vad32m/acid_vaporizer/MCAD/isometry view bottom.png

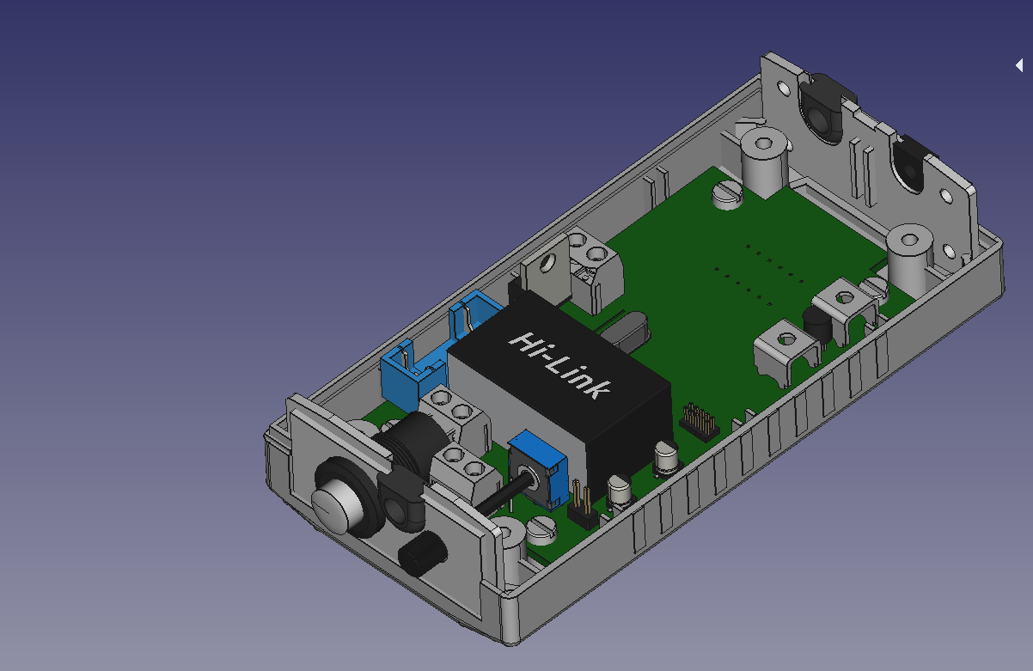
MCAD/isometry view bottom.png
