vad32m/acid_vaporizer/MCAD/isometry view top.png

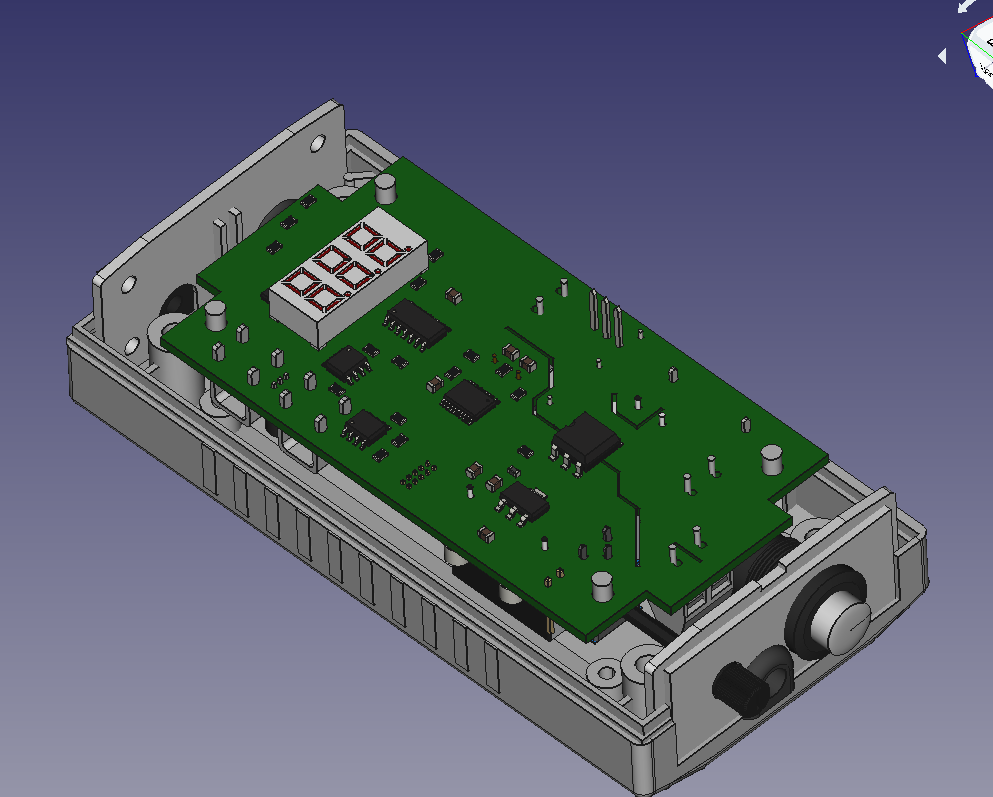
MCAD/isometry view top.png
