vad32m/acid_vaporizer/ECAD/pcb_renders.png

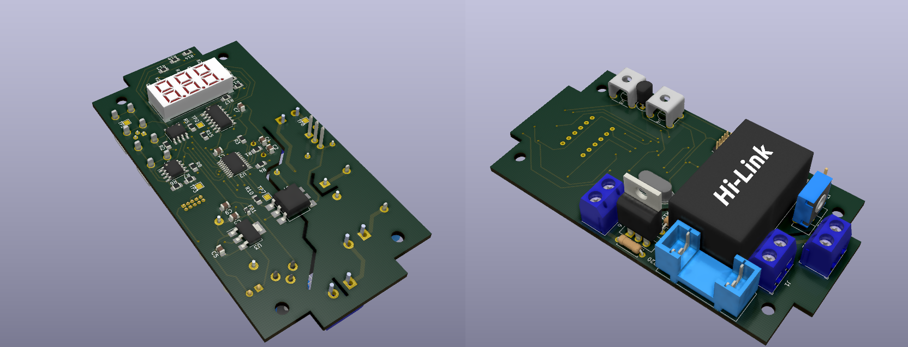
ECAD/pcb_renders.png
