vad32m/acid_vaporizer/MCAD/VAPORIZER_ASSEMBLED.FCStd

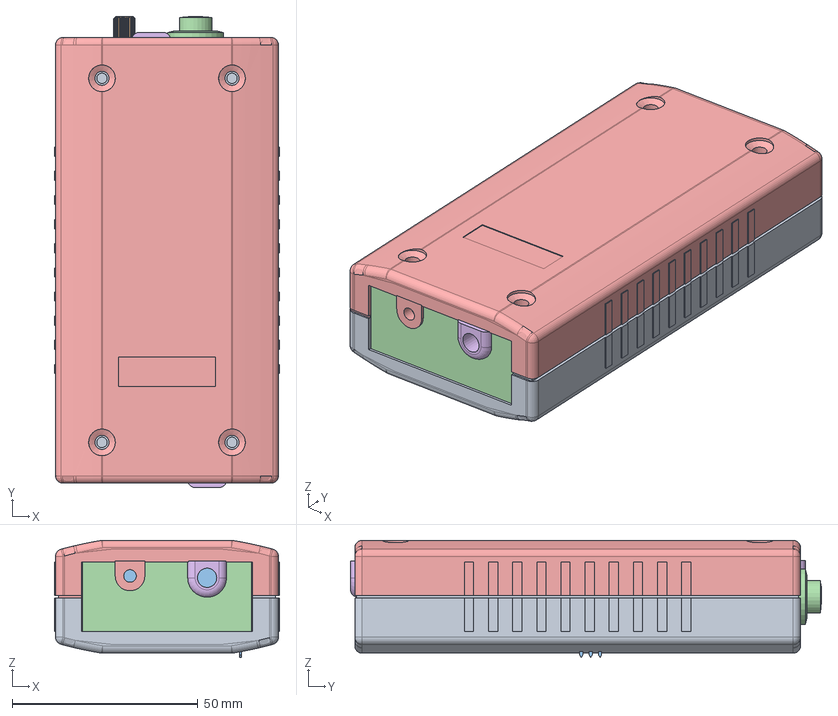
[picture p4: CAD file, 2020-11-08]
MCAD/VAPORIZER_ASSEMBLED.FCStd
60.6 x 126.8 x 31.6 mm
ENCLOSURE_TOP_001
CA9MA39_001
ENCLOSURE_SIDE_A_001
BUTTON_ASSEMBLED_001
ENCLOSURE_BOTTOM_001
FIX-GR-39_001
M3x5-Screw_001
M3x5-Screw_002
M3x5-Screw_003
M3x5-Screw_004
acid_vaporizer1_001
ENCLOSURE_SIDE_B_001
FIX-GR-35_001
FIX-GR-39_002
