vad32m/acid_vaporizer/MCAD/BUTTON_ASSEMBLED.FCStd

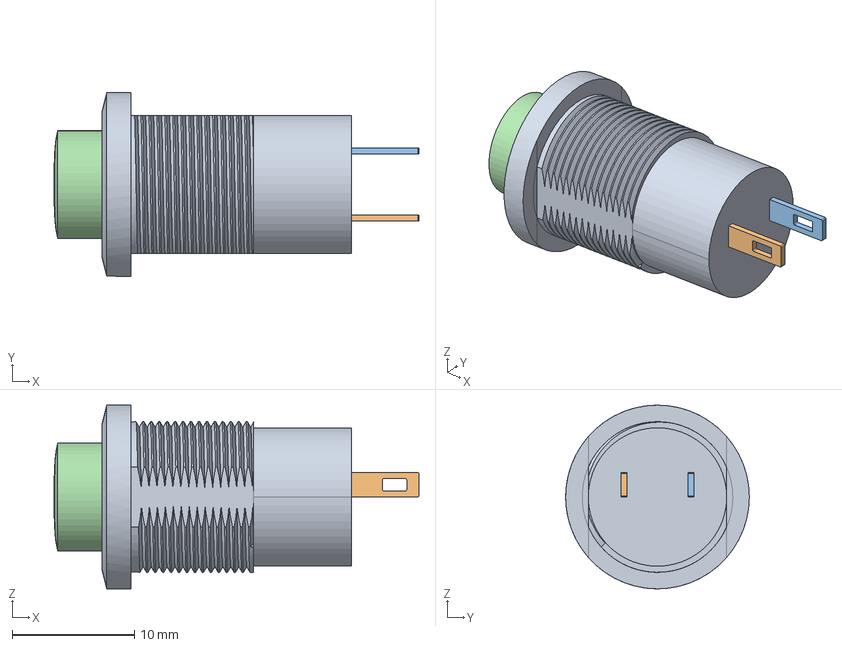
[picture p5: CAD file, 2020-11-08]
MCAD/BUTTON_ASSEMBLED.FCStd
29.8 x 15.0 x 15.0 mm
BUTTON_BODY_001
BUTTON_PIN_001
BUTTON_PIN_002
BUTTON_PAD_001
