vad32m/acid_vaporizer/MCAD/HV1216.FCStd

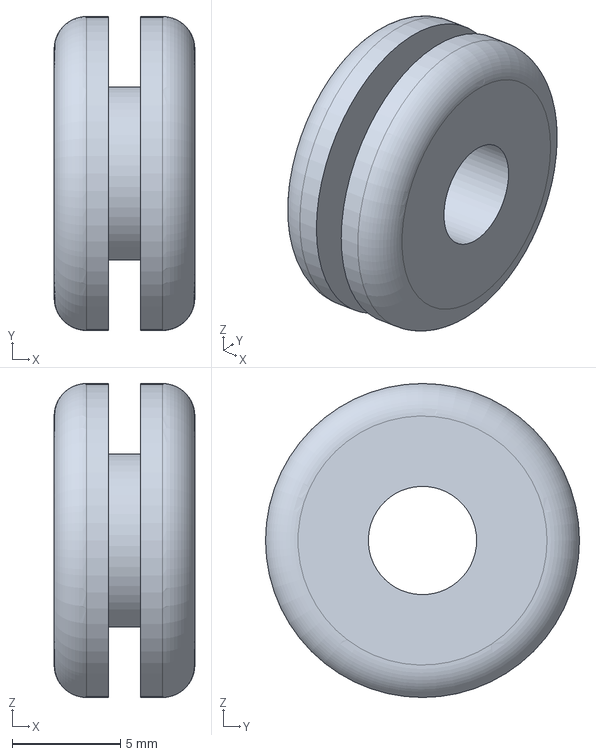
[picture p6: CAD file, 2020-11-08]
MCAD/HV1216.FCStd
6.50 x 14.5 x 14.5 mm
