vad32m/acid_vaporizer/MCAD/CA9MA39.FCStd

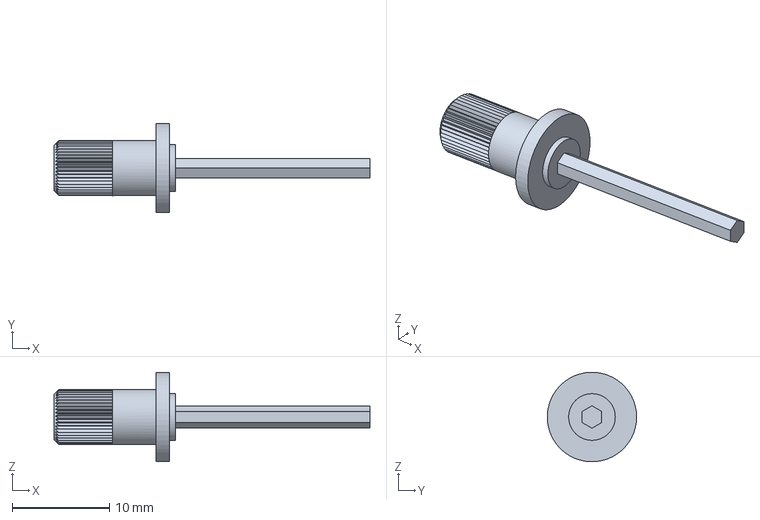
[picture p7: CAD file, 2020-11-08]
MCAD/CA9MA39.FCStd
32.5 x 9.19 x 9.20 mm
