vad32m/acid_vaporizer/MCAD/BUTTON_PIN.FCStd

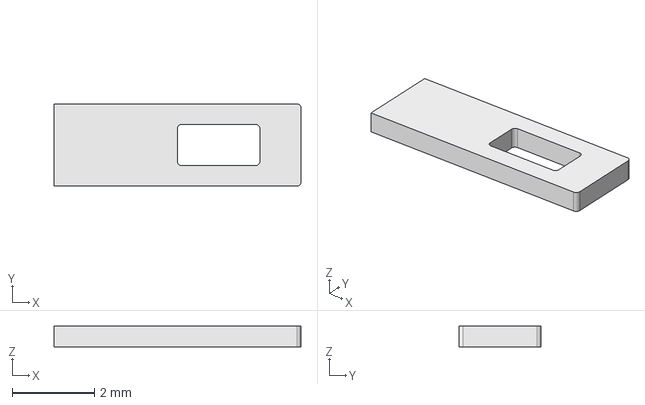
[picture p8: CAD file, 2020-11-08]
MCAD/BUTTON_PIN.FCStd
6.00 x 2.00 x 0.5 mm
