vad32m/acid_vaporizer/MCAD/FIX-GR-35.FCStd

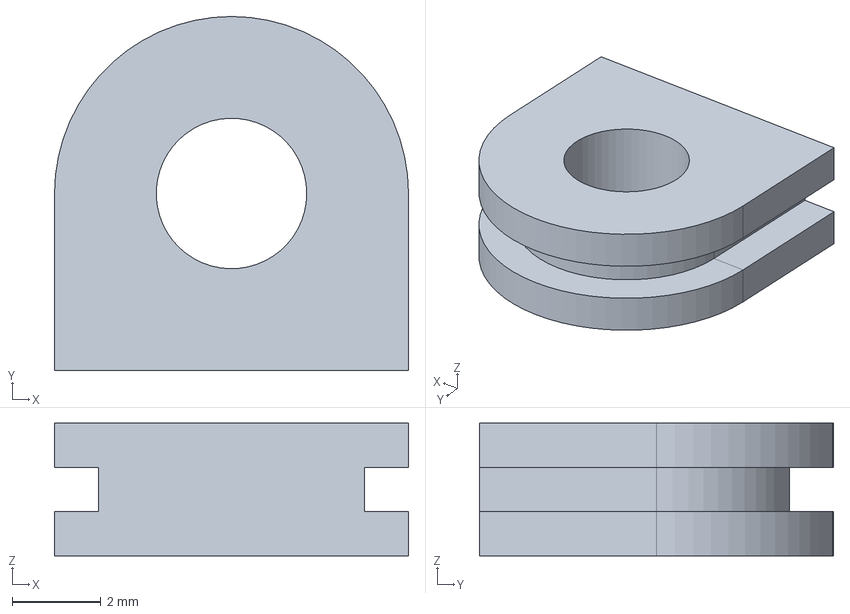
[picture p9: CAD file, 2020-11-08]
MCAD/FIX-GR-35.FCStd
8.00 x 8.00 x 3.00 mm
