vad32m/acid_vaporizer/MCAD/BUTTON_PAD.FCStd

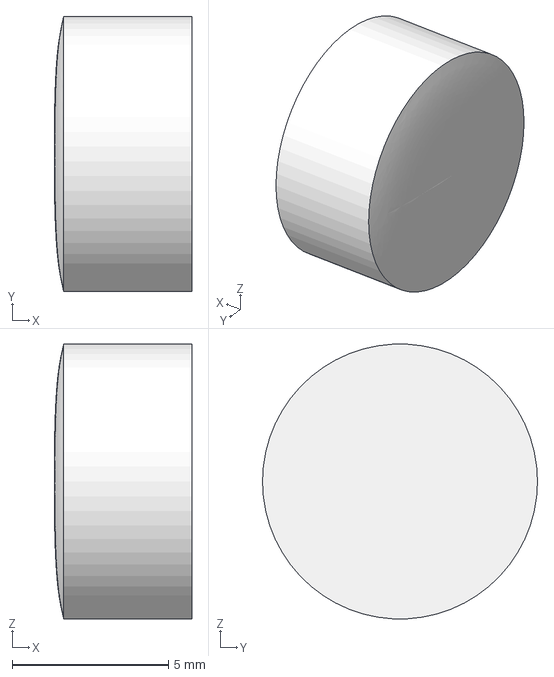
[picture p10: CAD file, 2020-11-08]
MCAD/BUTTON_PAD.FCStd
4.40 x 8.80 x 8.79 mm
