vad32m/acid_vaporizer/MCAD/ENCLOSURE_SIDE_A.FCStd

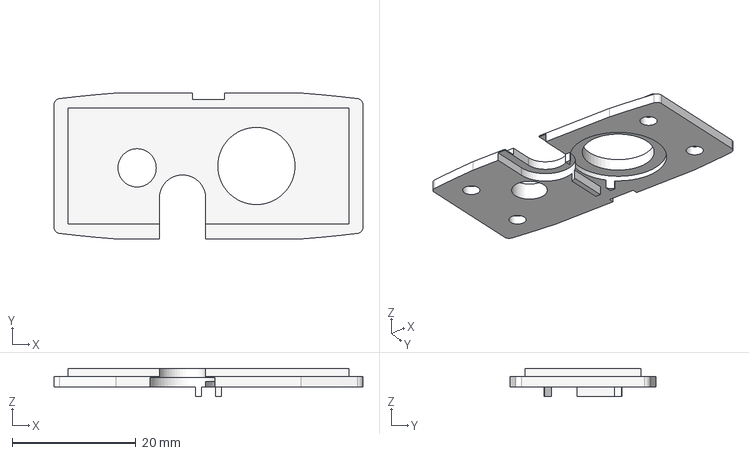
[picture p11: CAD file, 2020-11-08]
MCAD/ENCLOSURE_SIDE_A.FCStd
50.0 x 23.6 x 4.60 mm
