vad32m/acid_vaporizer/MCAD/ENCLOSURE_TOP.FCStd

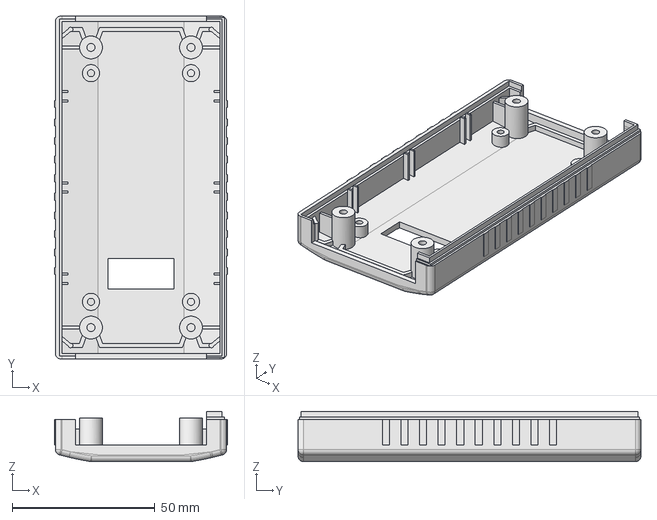
[picture p12: CAD file, 2020-11-08]
MCAD/ENCLOSURE_TOP.FCStd
60.6 x 120.0 x 17.6 mm
