vad32m/acid_vaporizer/MCAD/ENCLOSURE_SIDE_B.FCStd

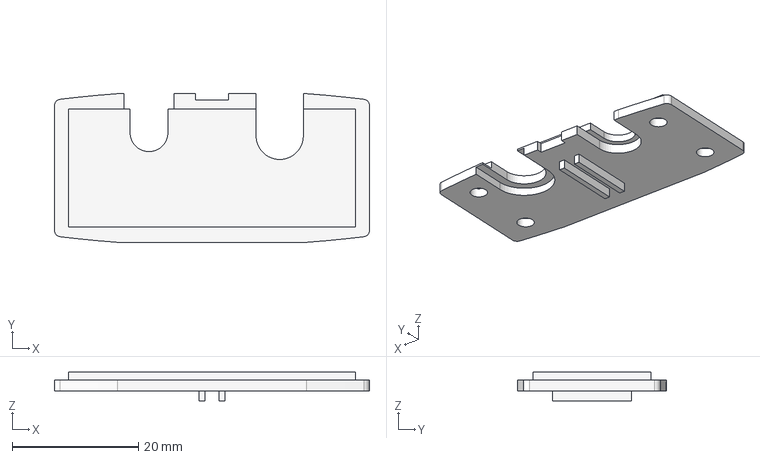
[picture p13: CAD file, 2020-11-08]
MCAD/ENCLOSURE_SIDE_B.FCStd
50.0 x 23.6 x 4.60 mm
