vad32m/acid_vaporizer/MCAD/BUTTON_BODY.FCStd

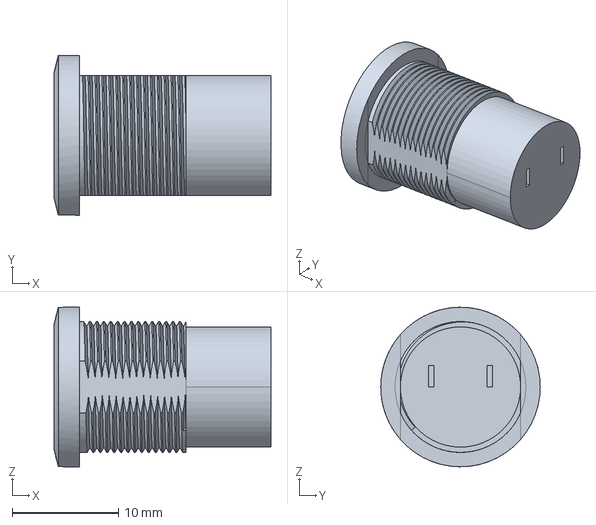
[picture p14: CAD file, 2020-11-08]
MCAD/BUTTON_BODY.FCStd
20.4 x 15.0 x 15.0 mm
