vad32m/acid_vaporizer/MCAD/ENCLOSURE_BOTTOM.FCStd

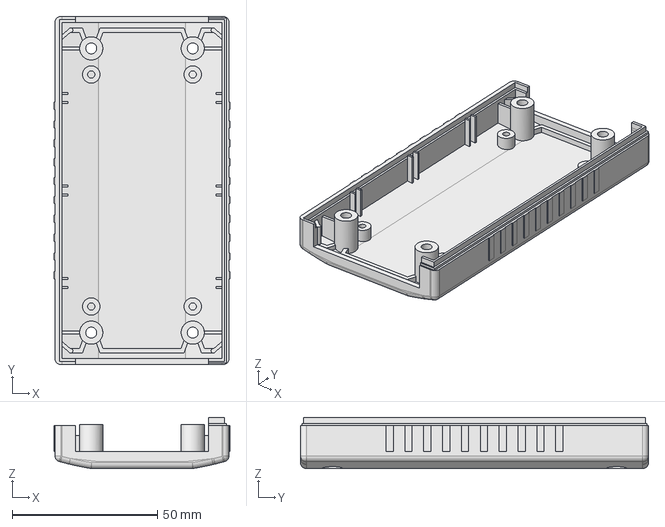
[picture p15: CAD file, 2020-11-08]
MCAD/ENCLOSURE_BOTTOM.FCStd
60.6 x 120.0 x 17.6 mm
