vad32m/acid_vaporizer/MCAD/FIX-GR-39.FCStd

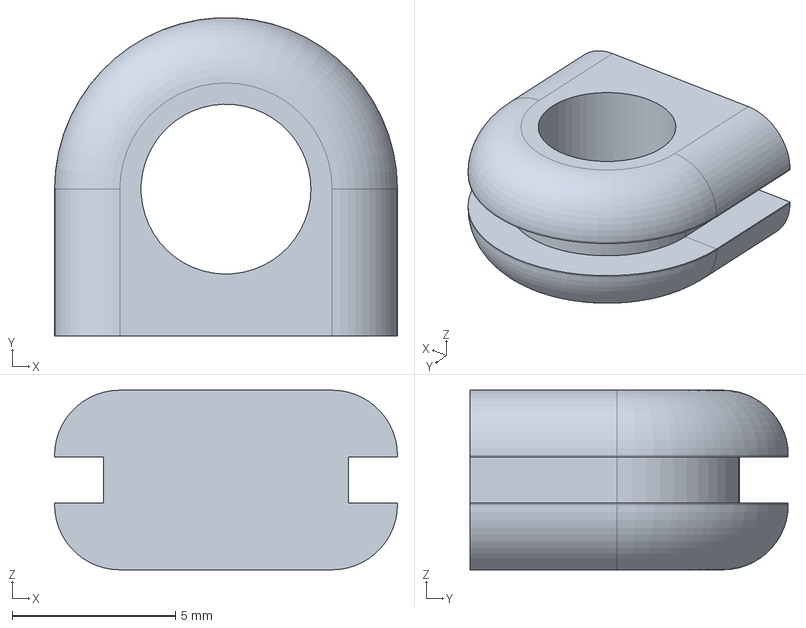
[picture p16: CAD file, 2020-11-08]
MCAD/FIX-GR-39.FCStd
10.5 x 9.74 x 5.50 mm
