vad32m/acid_vaporizer/ECAD/acid_vaporizer.kicad_pcb

## KiCad design ECAD/acid_vaporizer.kicad_pcb (2021-03-28)

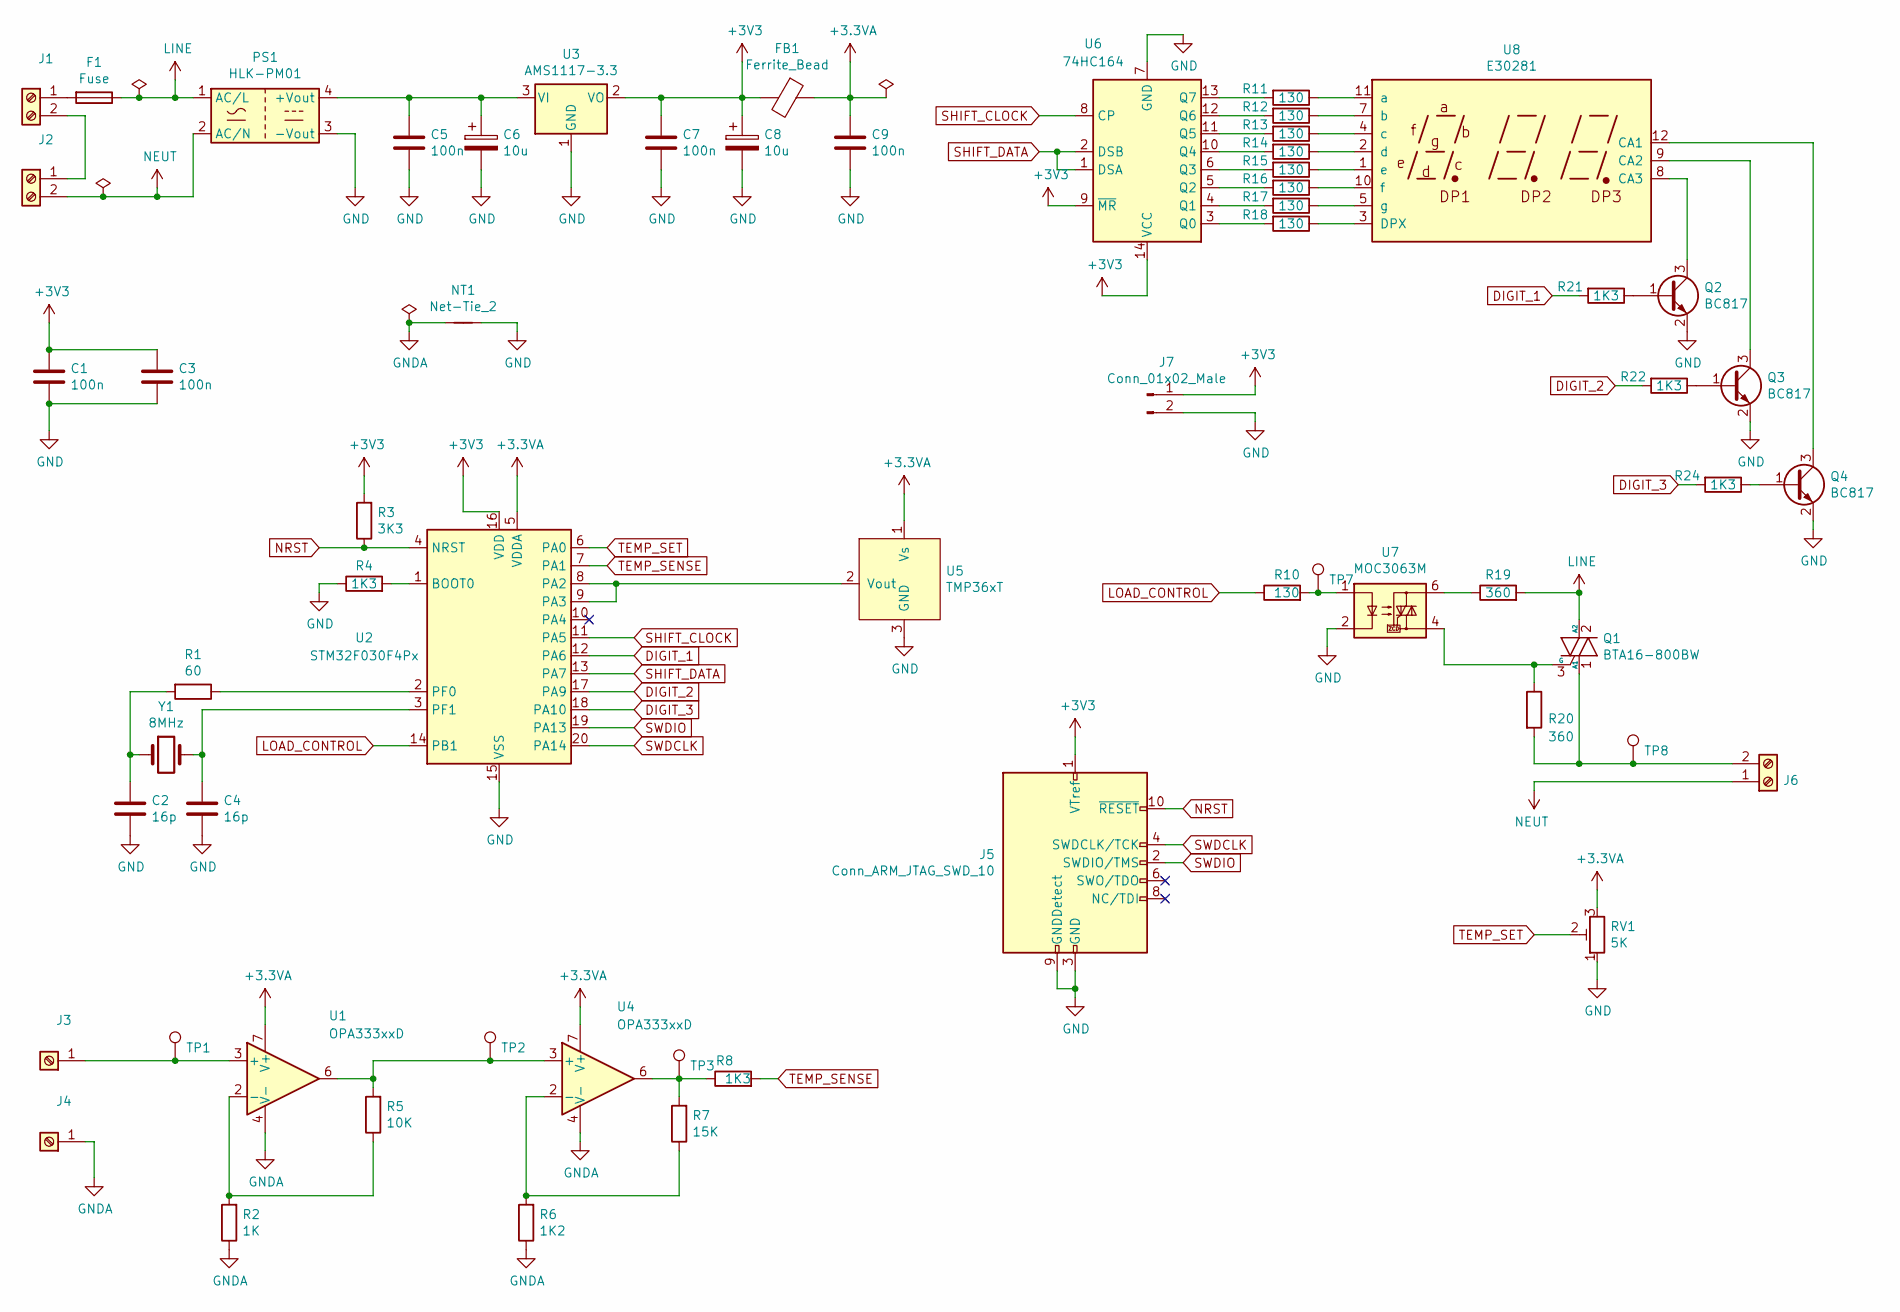
[picture p17: schematic acid_vaporizer.sch]

Parts:
C1, C3, C5, C7, C9: 100n; C_0805_2012Metric
C2, C4: 16p; C_0805_2012Metric
C6, C8: 10u; CP_Elec_4x5.3
F1: Fuse; FH5-1098
FB1: Ferrite_Bead; L_0603_1608Metric
J1, J2, J6: Screw_Terminal_01x02; TerminalBlock_1x02_P5.00mm_Horizontal
J3, J4: Screw_Terminal_01x01; K14-00(AH)
J5: Conn_ARM_JTAG_SWD_10; PinHeader_2x05_P1.27mm_Vertical
J7: Conn_01x02_Male; PinHeader_1x02_P2.54mm_Vertical
NT1: Net-Tie_2; NetTie-2_SMD_Pad0.5mm
PS1: HLK-PM01; HiLink_HLK-PMxx
Q1: BTA16-800BW; TO-220-3_Vertical
Q2, Q3, Q4: BC817; SOT-23
R1: 60; R_0805_2012Metric_Pad1.15x1.40mm_HandSolder
R2: 1K; R_0805_2012Metric_Pad1.15x1.40mm_HandSolder
R3: 3K3; R_0805_2012Metric_Pad1.15x1.40mm_HandSolder
R4, R8, R21, R22, R24: 1K3; R_0805_2012Metric_Pad1.15x1.40mm_HandSolder
R5: 10K; R_0805_2012Metric_Pad1.15x1.40mm_HandSolder
R6: 1K2; R_0805_2012Metric_Pad1.15x1.40mm_HandSolder
R7: 15K; R_0805_2012Metric_Pad1.15x1.40mm_HandSolder
R10, R11, R12, R13, R14, R15, R16, R17, R18: 130; R_0805_2012Metric_Pad1.15x1.40mm_HandSolder
R19: 360; R_Axial_DIN0207_L6.3mm_D2.5mm_P10.16mm_Horizontal
R20: 360; R_Axial_DIN0207_L6.3mm_D2.5mm_P7.62mm_Horizontal
RV1: 5K; Potentiometer_ACP_CA9-H2,5_Horizontal
TP1, TP2, TP3, TP7, TP8: TestPoint; TestPoint_Pad_1.5x1.5mm
U1, U4: OPA333xxD; SOIC-8_3.9x4.9mm_P1.27mm
U2: STM32F030F4Px; TSSOP-20_4.4x6.5mm_P0.65mm
U3: AMS1117-3.3; SOT-223-3_TabPin2
U5: TMP36xT; TO-92
U6: 74HC164; SOIC-14_3.9x8.7mm_P1.27mm
U7: MOC3063M; SMDIP-6_W9.53mm
U8: E30281
Y1: 8MHz; Crystal_HC49-4H_Vertical

Connections:
+3.3VA: C9.1, FB1.1, RV1.3, U1.7 (V+), U2.5 (VDDA), U4.7 (V+), U5.1 (Vs)
+3V3: C1.1, C3.1, C7.1, C8.1, FB1.2, J5.1 (VTref), J7.1, R3.2, U2.16 (VDD), U3.2 (VO), U6.9 (~MR), U6.14 (VCC)
DIGIT_1: R21.2, U2.12 (PA6)
DIGIT_2: R22.2, U2.17 (PA9)
DIGIT_3: R24.2, U2.18 (PA10)
GND: C1.2, C2.2, C3.2, C4.2, C5.2, C6.2, C7.2, C8.2, C9.2, J5.3 (GND), J5.5 (GND), J5.9 (GNDDetect), J7.2, NT1.2, PS1.3 (-Vout), Q2.2 (E), Q3.2 (E), Q4.2 (E), R4.1, RV1.1, U2.15 (VSS), U3.1 (GND), U5.3 (GND), U6.7 (GND), U7.2
GNDA: J4.1, NT1.1, R2.1, R6.1, U1.4 (V-), U4.4 (V-)
LINE: F1.1, PS1.1 (AC/L), Q1.2 (A2), R19.2
LOAD_CONTROL: R10.1, U2.14 (PB1)
NEUT: J2.2, J6.1, PS1.2 (AC/N)
NRST: J5.10 (~RESET~), R3.1, U2.4 (NRST)
unnamed: C2.1, R1.2, Y1.1
unnamed: C4.1, U2.3 (PF1), Y1.2
unnamed: C5.1, C6.1, PS1.4 (+Vout), U3.3 (VI)
unnamed: F1.2, J1.1
unnamed: J1.2, J2.1
unnamed: J3.1, TP1.1, U1.3 (+)
unnamed: J6.2, Q1.1 (A1), R20.2, TP8.1
unnamed: Q1.3 (G), R20.1, U7.4
unnamed: Q2.1 (B), R21.1
unnamed: Q2.3 (C), U8.8 (CA3)
unnamed: Q3.1 (B), R22.1
unnamed: Q3.3 (C), U8.9 (CA2)
unnamed: Q4.1 (B), R24.1
unnamed: Q4.3 (C), U8.12 (CA1)
unnamed: R1.1, U2.2 (PF0)
unnamed: R2.2, R5.1, U1.2 (-)
unnamed: R4.2, U2.1 (BOOT0)
unnamed: R5.2, TP2.1, U1.6, U4.3 (+)
unnamed: R6.2, R7.1, U4.2 (-)
unnamed: R7.2, R8.1, TP3.1, U4.6
unnamed: R10.2, TP7.1, U7.1
unnamed: R11.1, U8.11 (a)
unnamed: R11.2, U6.13 (Q7)
unnamed: R12.1, U8.7 (b)
unnamed: R12.2, U6.12 (Q6)
unnamed: R13.1, U8.4 (c)
unnamed: R13.2, U6.11 (Q5)
unnamed: R14.1, U8.2 (d)
unnamed: R14.2, U6.10 (Q4)
unnamed: R15.1, U8.1 (e)
unnamed: R15.2, U6.6 (Q3)
unnamed: R16.1, U8.10 (f)
unnamed: R16.2, U6.5 (Q2)
unnamed: R17.1, U8.5 (g)
unnamed: R17.2, U6.4 (Q1)
unnamed: R18.1, U8.3 (DPX)
unnamed: R18.2, U6.3 (Q0)
unnamed: R19.1, U7.6
unnamed: U2.8 (PA2), U2.9 (PA3), U5.2 (Vout)
SHIFT_CLOCK: U2.11 (PA5), U6.8 (CP)
SHIFT_DATA: U2.13 (PA7), U6.1 (DSA), U6.2 (DSB)
SWDCLK: J5.4 (SWDCLK/TCK), U2.20 (PA14)
SWDIO: J5.2 (SWDIO/TMS), U2.19 (PA13)
TEMP_SENSE: R8.2, U2.7 (PA1)
TEMP_SET: RV1.2, U2.6 (PA0)

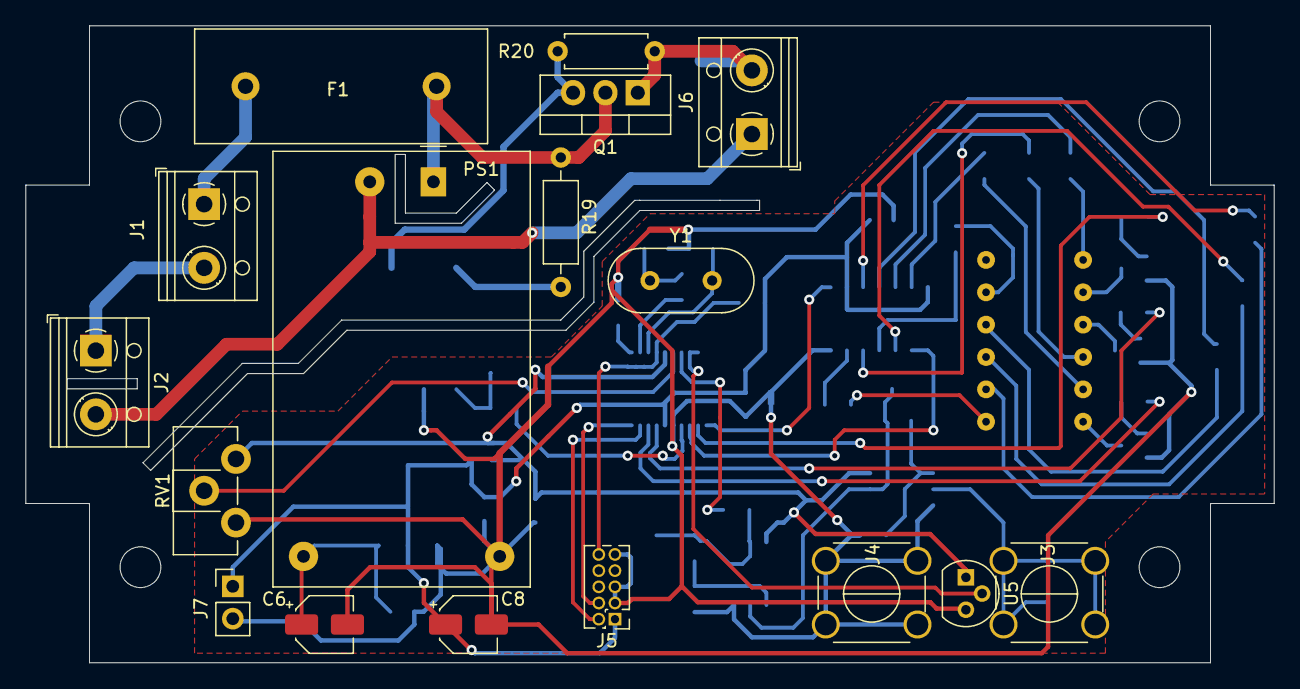
[picture p18: board acid_vaporizer.kicad_pcb from above]

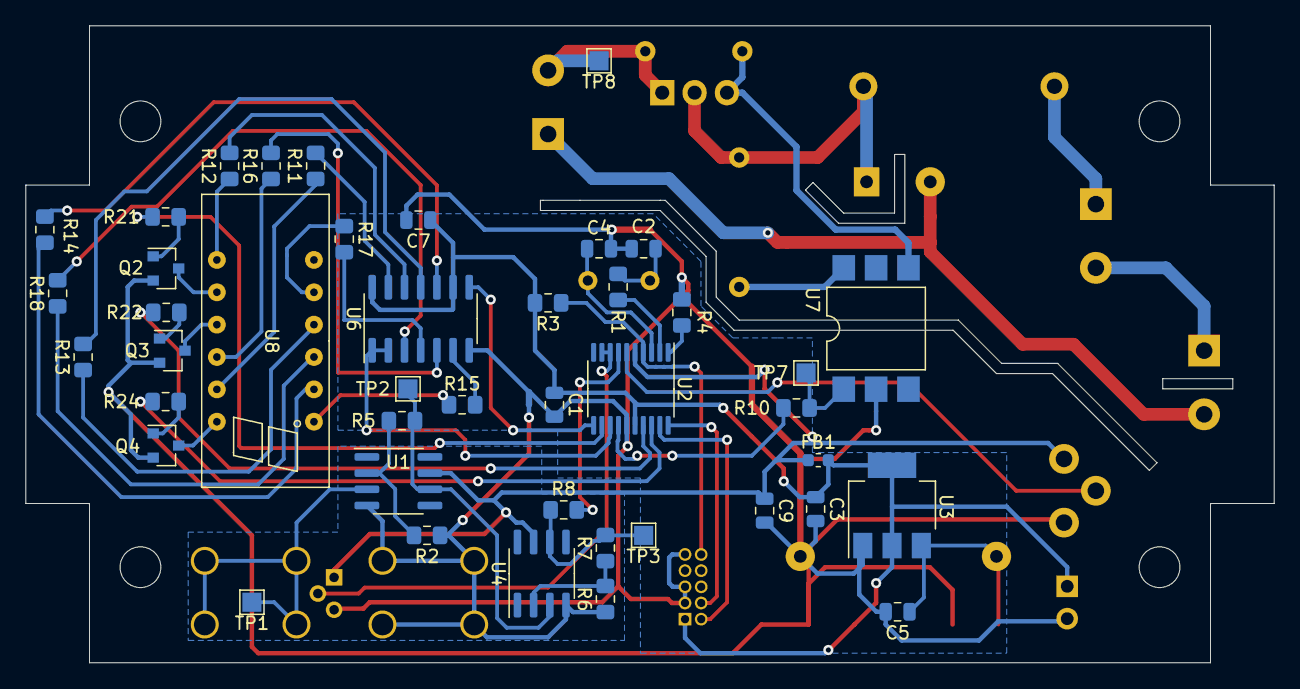
[picture p19: board acid_vaporizer.kicad_pcb from below]

Board: 2 copper layers, 98.0 x 50.0 mm, 61 parts (44 on the bottom side), 56 nets.
