vad32m/acid_vaporizer/MCAD/VAPORIZER_ASSEMBLED_asm_hierarchy.html

graph TD ENCLOSURE_TOP_001(ENCLOSURE_TOP_001
*FIXED*) -- axial --> ENCLOSURE_BOTTOM_001 ENCLOSURE_TOP_001(ENCLOSURE_TOP_001
*FIXED*) -- axial --> ENCLOSURE_BOTTOM_001 ENCLOSURE_TOP_001(ENCLOSURE_TOP_001
*FIXED*) -- axial --> M3x5-Screw_001 ENCLOSURE_TOP_001(ENCLOSURE_TOP_001
*FIXED*) -- axial --> M3x5-Screw_002 ENCLOSURE_TOP_001(ENCLOSURE_TOP_001
*FIXED*) -- axial --> M3x5-Screw_003 ENCLOSURE_TOP_001(ENCLOSURE_TOP_001
*FIXED*) -- axial --> M3x5-Screw_004 ENCLOSURE_TOP_001(ENCLOSURE_TOP_001
*FIXED*) -- axial --> acid_vaporizer1_001 ENCLOSURE_TOP_001(ENCLOSURE_TOP_001
*FIXED*) -- axial --> acid_vaporizer1_001 ENCLOSURE_TOP_001(ENCLOSURE_TOP_001
*FIXED*) -- plane --> acid_vaporizer1_001 ENCLOSURE_TOP_001(ENCLOSURE_TOP_001
*FIXED*) -- plane --> ENCLOSURE_SIDE_A_001 ENCLOSURE_TOP_001(ENCLOSURE_TOP_001
*FIXED*) -- axial --> ENCLOSURE_SIDE_A_001 ENCLOSURE_TOP_001(ENCLOSURE_TOP_001
*FIXED*) -- plane --> ENCLOSURE_SIDE_B_001 ENCLOSURE_TOP_001(ENCLOSURE_TOP_001
*FIXED*) -- plane --> ENCLOSURE_SIDE_B_001 ENCLOSURE_TOP_001(ENCLOSURE_TOP_001
*FIXED*) -- plane --> ENCLOSURE_SIDE_B_001 ENCLOSURE_BOTTOM_001 M3x5-Screw_001 -- pointOnPlane --> acid_vaporizer1_001 M3x5-Screw_002 -- pointOnPlane --> acid_vaporizer1_001 M3x5-Screw_003 -- pointOnPlane --> acid_vaporizer1_001 M3x5-Screw_004 -- pointOnPlane --> acid_vaporizer1_001 acid_vaporizer1_001 -- plane --> CA9MA39_001 CA9MA39_001 ENCLOSURE_SIDE_A_001 -- axial --> BUTTON_ASSEMBLED_001 ENCLOSURE_SIDE_A_001 -- plane --> BUTTON_ASSEMBLED_001 ENCLOSURE_SIDE_A_001 -- axial --> FIX-GR-39_001 ENCLOSURE_SIDE_A_001 -- plane --> FIX-GR-39_001 BUTTON_ASSEMBLED_001 FIX-GR-39_001 ENCLOSURE_SIDE_B_001 -- axial --> FIX-GR-35_001 ENCLOSURE_SIDE_B_001 -- plane --> FIX-GR-35_001 ENCLOSURE_SIDE_B_001 -- axial --> FIX-GR-39_002 ENCLOSURE_SIDE_B_001 -- planesParallel --> FIX-GR-39_002 ENCLOSURE_SIDE_B_001 -- plane --> FIX-GR-39_002 FIX-GR-35_001 FIX-GR-39_002
