vad32m/acid_vaporizer/SRC/Core/Src/main.c

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
/* Includes ------------------------------------------------------------------*/
#include "main.h"

/* USER CODE BEGIN Includes */
#include "display.h"
#include "sensors.h"
#include "load_control.h"
#include "pi_controller.h"

/* USER CODE END Includes */


/* USER CODE BEGIN PV */
uint16_t desiredTemp;
	SENSORS_Readings readings;
/* USER CODE END PV */

void SystemClock_Config(void);
static void MX_GPIO_Init(void);
static void MX_ADC_Init(void);
static void MX_SPI1_Init(void);
static void MX_TIM3_Init(void);
static void MX_TIM14_Init(void);
/* USER CODE BEGIN 0 */
static void onLoadCycleEnd(void)
{
	uint16_t output = 0;

	readings = SENSORS_getReadings();

	output = PI_process(readings.coldJunctionTemp + readings.thermocoupleTemp);

	if (output > UINT8_MAX)
	{
		output = UINT8_MAX;
	}

	LOAD_CONTROL_setLoad(output);
}
/* USER CODE END 0 */

/**
  * @brief  The application entry point.
  * @retval int
  */
int main(void)
{
  /* MCU Configuration--------------------------------------------------------*/

  /* Reset of all peripherals, Initializes the Flash interface and the Systick. */

  LL_APB1_GRP2_EnableClock(LL_APB1_GRP2_PERIPH_SYSCFG);
  LL_APB1_GRP1_EnableClock(LL_APB1_GRP1_PERIPH_PWR);

  /* System interrupt init*/

  /* Configure the system clock */
  SystemClock_Config();

  /* Initialize all configured peripherals */
  MX_GPIO_Init();
  MX_ADC_Init();
  MX_SPI1_Init();
  MX_TIM3_Init();
  MX_TIM14_Init();
  /* USER CODE BEGIN 2 */
  DISPLAY_Init();
  SENSORS_init();
  LOAD_CONTROL_init();

  uint8_t loopsWithoutChange = 0;
  uint16_t potValue = 0;

  DISPLAY_StartBlinking();

  while (loopsWithoutChange < 10)
  {
	  LL_mDelay(500);
	  readings = SENSORS_getReadings();

	  if ((readings.potentiometerAngle <= potValue + 1)
		  && (readings.potentiometerAngle >= potValue - 1))
	  {
		  loopsWithoutChange++;
	  }
	  else
	  {
		  loopsWithoutChange = 0;
	  }

	  potValue = readings.potentiometerAngle;
	  DISPLAY_SetNumber(200 + potValue);
  }

  desiredTemp = 200 + potValue;

  PI_params controllerParams =
  {
  		.desired = desiredTemp,
		.integratorCoef = 0.1,
		.proportionalCoef = 4.0,
		.integratorMax = 250,
		.integratorMin = -200,
  };

  DISPLAY_StopBlinking();

  PI_init(&controllerParams);

  LOAD_CONTROL_setCycleEndedCallback(onLoadCycleEnd);
  /* USER CODE END 2 */

  /* Infinite loop */
  /* USER CODE BEGIN WHILE */
  while (1)
  {

    /* USER CODE END WHILE */
    LL_mDelay(1000);
    DISPLAY_SetNumber(readings.thermocoupleTemp + readings.coldJunctionTemp);

    /* USER CODE BEGIN 3 */
  }
  /* USER CODE END 3 */
}

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
