vad32m/acid_vaporizer/SRC/acid_vaporizer.ioc

Mcu.UserName=STM32F030F4Px
PA0.Signal=ADC_IN0
PA1.Signal=ADC_IN1
PA10.Signal=GPIO_Output
PA13.Signal=SYS_SWDIO
PA14.Signal=SYS_SWCLK
PA2.Signal=ADC_IN2
PA3.Signal=ADC_IN3
PA5.Signal=SPI1_SCK
PA6.Signal=GPIO_Output
PA7.Signal=SPI1_MOSI
PA9.Signal=GPIO_Output
PB1.Signal=S_TIM3_CH4
PF0-OSC_IN.Signal=RCC_OSC_IN
PF1-OSC_OUT.Signal=RCC_OSC_OUT
