vad32m/acid_vaporizer/(commit log)

2020-11-08 Add initial version of schematic and PCB
    [acid_vaporizer.kicad_pcb, acid_vaporizer.sch]
2020-11-08 Add initial mechanical design version
    [BUTTON_ASSEMBLED.FCStd, BUTTON_BODY.FCStd, BUTTON_PAD.FCStd, BUTTON_PIN.FCStd, CA9MA39.FCStd, ENCLOSURE_BOTTOM.FCStd, ENCLOSURE_SIDE_A.FCStd, ENCLOSURE_SIDE_B.FCStd]
2021-03-20 Configure hardware timers for triac and display control
2021-03-20 Add initial implementation of display driver
2021-03-21 Add "blinking" functionality to display driver
2021-03-28 Schematic and PCB: replasce DS18B20 by TMP36
    [acid_vaporizer.kicad_pcb, acid_vaporizer.sch]
2021-03-28 Change configuration to read data from analog temperature senseor
2021-04-03 Add initial implementation for ADC module that reads sensors
2021-04-04 Add translation from voltages to units for sensors
2021-04-06 Add module for controlling PWM output
2021-04-09 Add timer callback for updating load control in sync with PWM
2021-04-30 Add images of PCB and device in enclosure
